shane2710/SmartKeurig/(commit log)

2015-12-10 updated code to work with raspberry pi via serial
2015-12-14 fixed serial end function
    [SmartFirmware_1.1.0.ino]
2015-12-14 fixing serial end function
    [SmartFirmware_1.1.3.ino]
